dfict/flying_fish/(commit log)

2024-06-26 added the sketch for karplus strong solar powered synth
2024-06-26 added PCB picture
2024-06-26 updated eeprom state for default power on after upload
2024-07-10 added temperature tester
2024-07-22 fixed bugs. all programs play 24 notes now
    [Flyingfish_v.04--711.ino]
2024-07-25 added debug code. huge! prints analogRead() values to serial monitor. need to read it over serial FTDI interface (not on current pcb)
2024-07-26 added notes on calibrating the temp sensor[A
2024-09-16 fixed the problems in FlyingMarlin! tuning is accurate now
    [Flyingfish_v.053.ino]
